electrickery/ps-2Keyboard2TRS-80/keyboardEmuTRS80.kicad_sch.bw.pdf

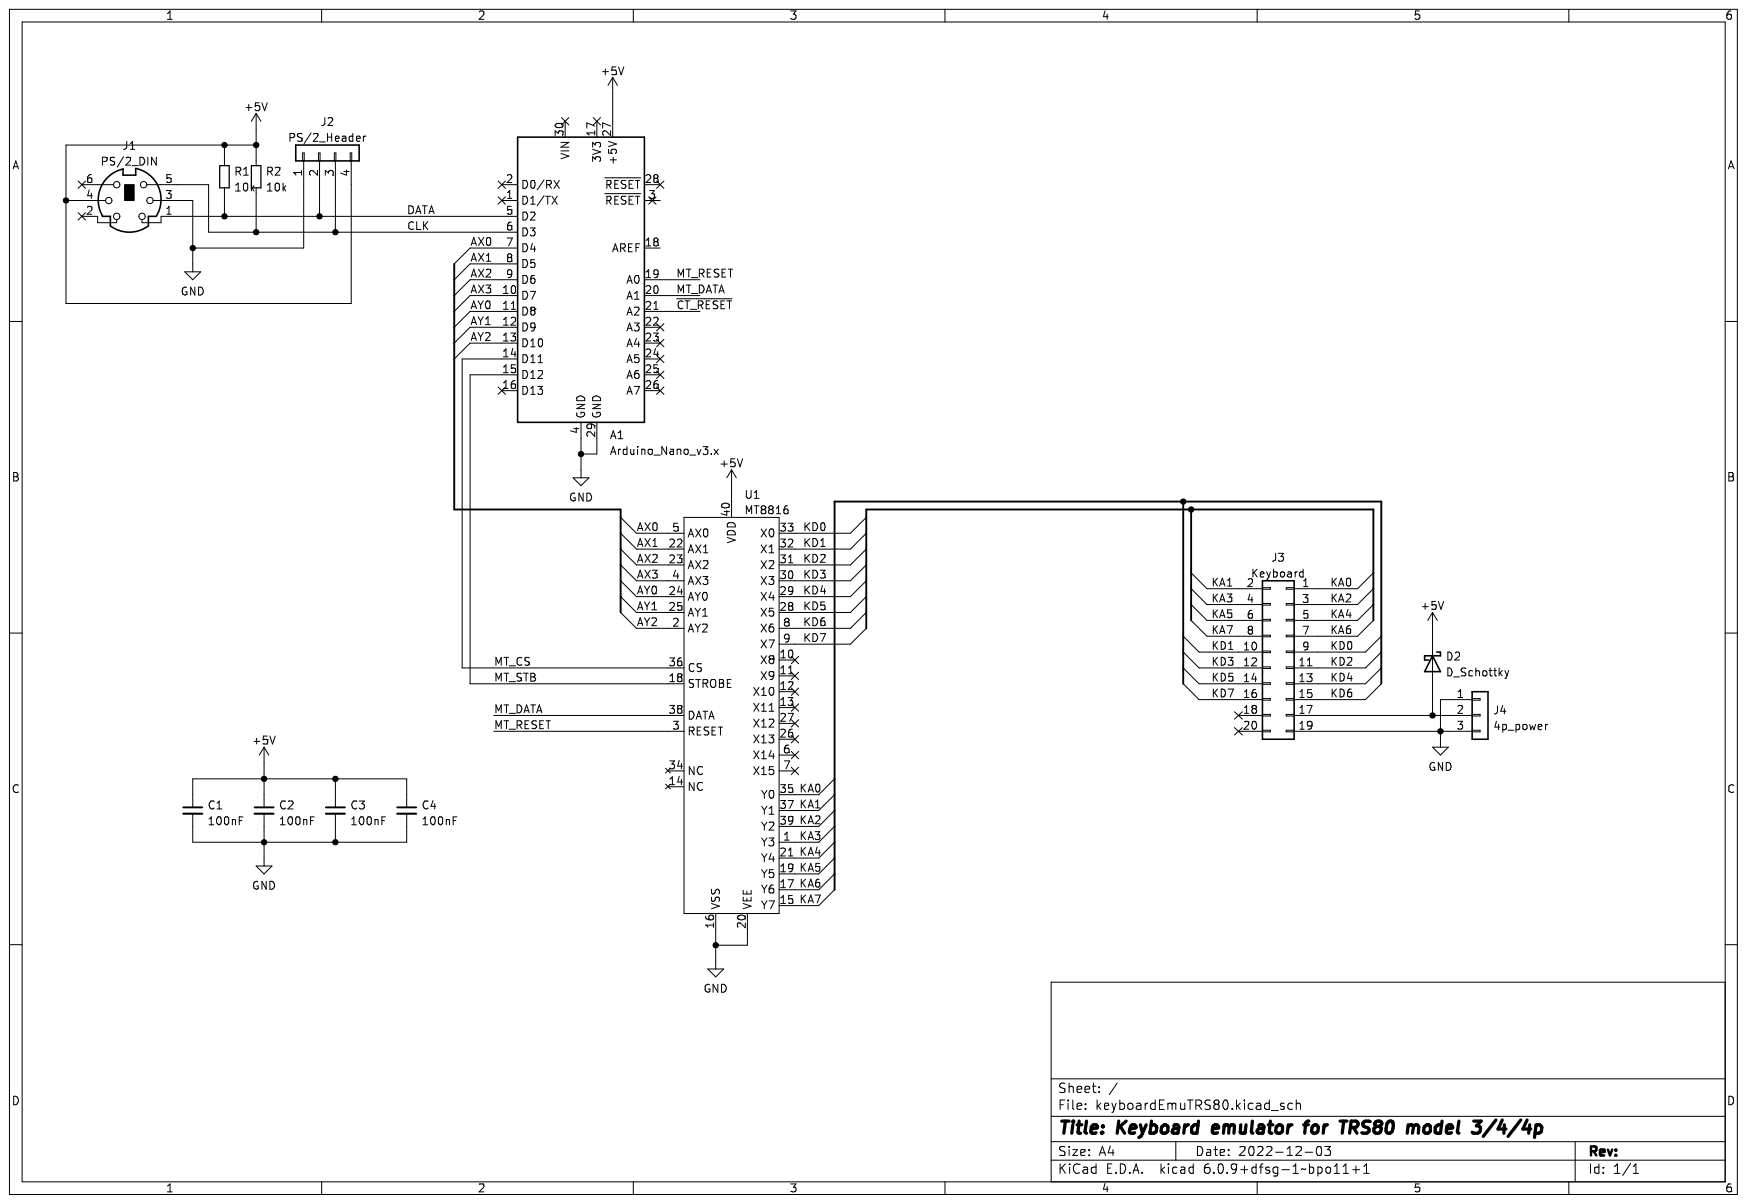
[picture p2: page 1]
