electrickery/ps-2Keyboard2TRS-80/keyboardEmuTRS80.kicad_sch.pdf

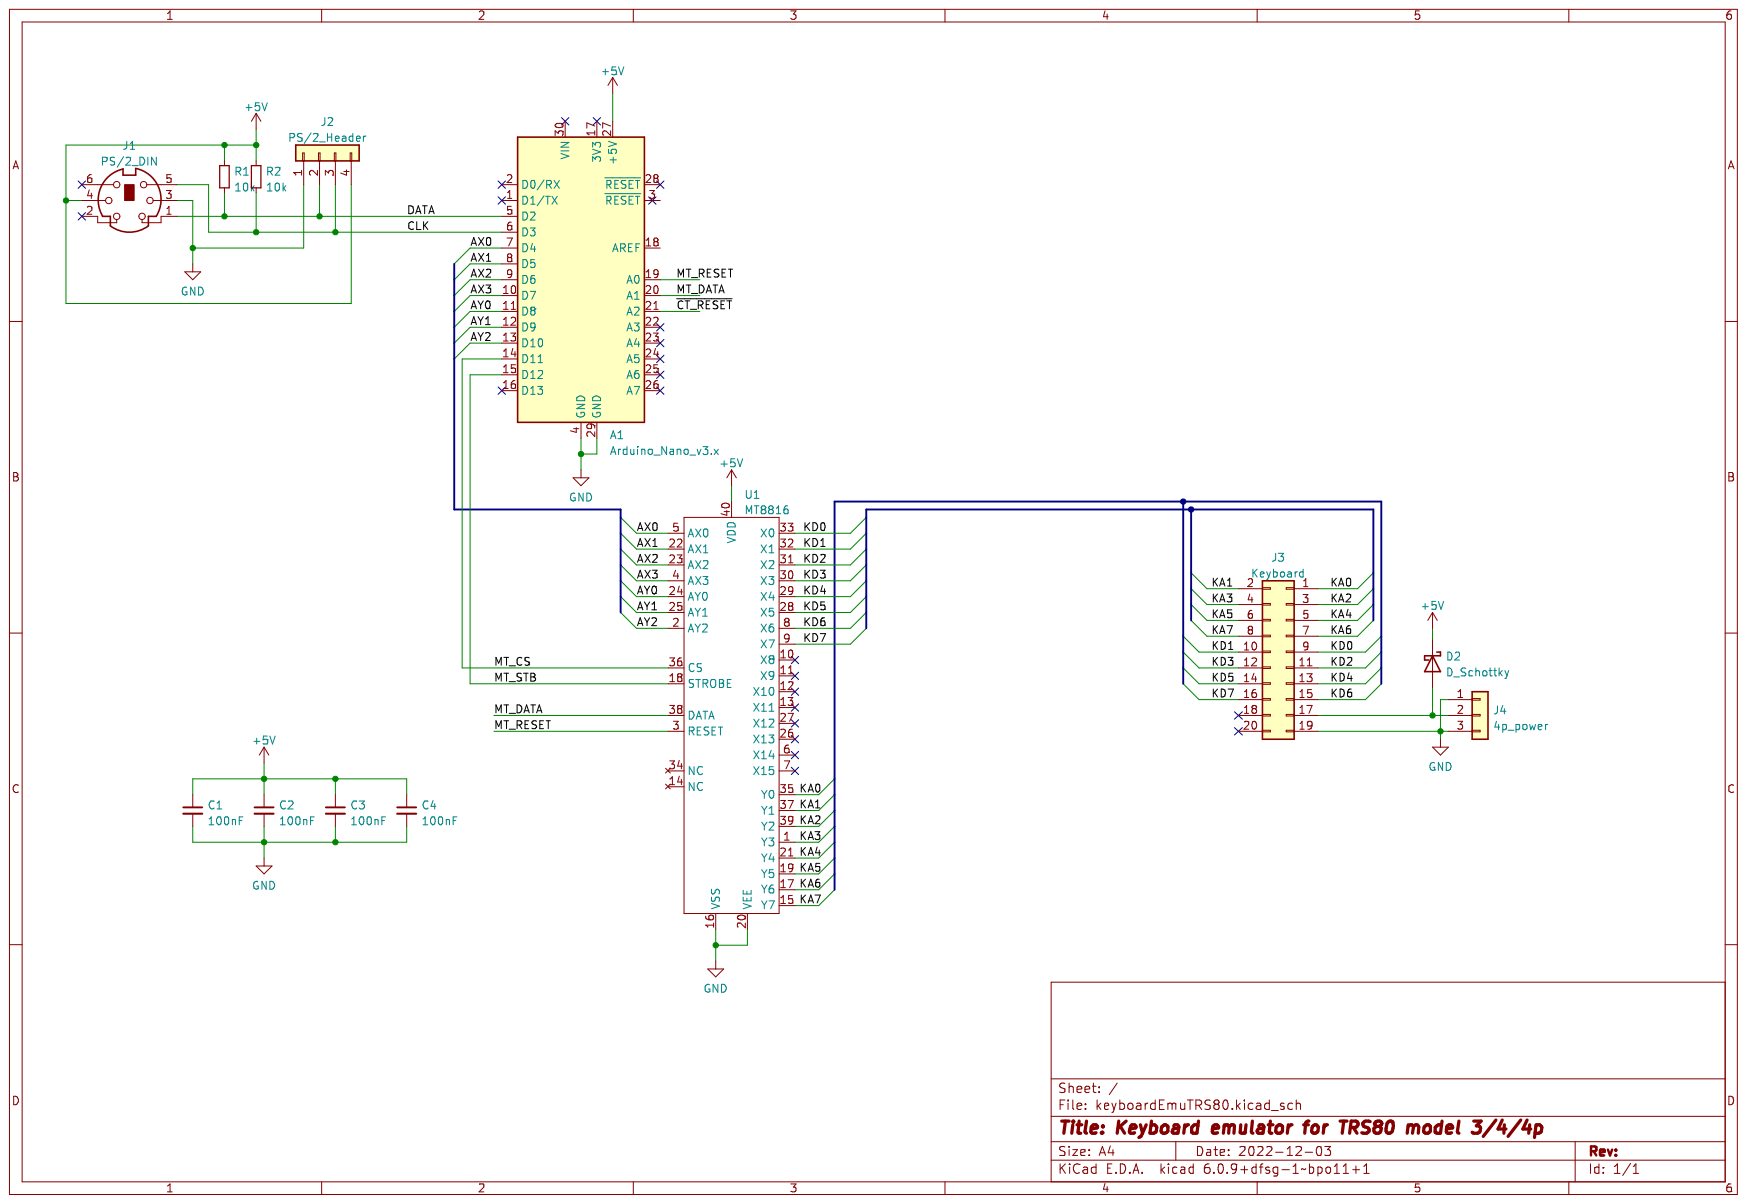
[picture p3: page 1]
