electrickery/ps-2Keyboard2TRS-80/(commit log)

2022-12-03 Added image, schematic, license.
2022-12-03 Info in 4p connector.
